hxming123456/stm32_power_measure_project/Power_measurement_self_fitting_v1.0/pyread/print.bmp

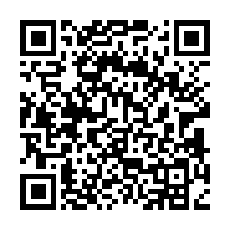
Power_measurement_self_fitting_v1.0/pyread/print.bmp
