hxming123456/stm32_power_measure_project/Power_measurement_self_fitting_v1.0/文档/1-13w功率点测量.xlsx

Sheet: Sheet1
测量点 | 白电表 | 灰电表 | 6530 | 6530带电表功率平均值 | 6530实际值 | 标准板 | 7766原始数据 | 6530空载 | 6530空载平均
1w | 1.6 | 2.03 | 2.57 | 1.6 | 0.97 | 1.68 | 55 5A 02 DD 98 00 03 63 00 3E 35 03 4B 83 4E 79 D8 2E 71 64 71 01 33 68 | 1.34 | 1.596585366
 | 1.6 | 2.03 | 2.16 | 1.6 | 0.56 | 1.78 | 55 5A 02 DD 98 00 03 61 00 3E 35 03 4E 91 4E 79 D8 2C 06 56 71 01 73 3C | 1.87
 | 1.6 | 2.05 | 3.04 | 1.6 | 1.44 | 1.66 | 55 5A 02 DD 98 00 03 62 00 3E 35 03 4C 8A 4E 79 D8 2F 45 05 71 01 95 47 | 1.05
 | 1.6 | 2.04 | 2.16 | 1.6 | 0.56 | 1.57 | 55 5A 02 DD 98 00 03 61 00 3E 35 03 44 90 4E 79 D8 31 F9 DF 71 01 AD EC | 1.87
 | 1.6 | 2.04 | 2.16 | 1.6 | 0.56 | 1.83 | 55 5A 02 DD 98 00 03 63 00 3E 35 03 56 C3 4E 79 D8 2A A7 F6 71 01 C3 07 | 1.34
3w | 3.8 | 3.87 | 3.04 | 1.6 | 1.44 | 3.51 | 55 5A 02 DD 98 00 03 5F 00 3E 35 03 41 38 4E 79 D8 16 5A F2 71 01 EB 26 | 1.34
 | 3.8 | 3.86 | 4.33 | 1.6 | 2.73 | 3.3 | 55 5A 02 DD 98 00 03 62 00 3E 35 03 4B A8 4E 79 D8 17 B6 D4 71 02 27 1F | 1.64
 | 3.8 | 3.84 | 5.33 | 1.6 | 3.73 | 3.43 | 55 5A 02 DD 98 00 03 63 00 3E 35 03 49 A8 4E 79 D8 16 D5 E8 71 02 59 82 | 1.34
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
