hxming123456/stm32_power_measure_project/Power_measurement_self_fitting_v1.0/文档/多个标准板数据对比.xlsx

Sheet: Sheet1
组数 | 6530功率 | 6530电压 | 6530电流 | 标准板功率 | 标准板电压 | 标准板电流 | 1-2000公式计算结果 | 公式计算误差 | 1-25公式计算结果 | 公式计算误差 | 功率误差百分比((标准板功率-6530功率)/6530功率) | 电压误差(标准板电压-6530电压) | 电流误差(标准板电流-6530电流)
1 | 1.5192 | 220.0702 | 0.0312 | 1.7356 | 216.8841 | 0.0729 | 1.48788396 | 2.10% | 1.44 | 5.49% | 14.24% | -3.19 | 0.04 | 0
 | 2.8572 | 220.0682 | 0.0312 | 3.3871 | 216.8591 | 0.0735 | 3.19570011 | -10.59% | 3.17 | -9.97% | 18.55% | -3.21 | 0.04 | 0
 | 3.8681 | 220.0672 | 0.0312 | 4.5252 | 217.3611 | 0.0752 | 4.37260932 | -11.54% | 4.37 | -11.45% | 16.99% | -2.71 | 0.04 | 0
 | 6.8652 | 220.0692 | 0.0412 | 6.5717 | 217.1098 | 0.0766 | 6.48889497 | 5.80% | 6.52 | 5.35% | -4.28% | -2.96 | 0.04 | 0
 | 8.6822 | 220.0772 | 0.0412 | 8.5388 | 216.8591 | 0.0816 | 8.52307308 | 1.87% | 8.58 | 1.17% | -1.65% | -3.22 | 0.04 | 0
 | 10.5852 | 220.0722 | 0.0412 | 10.3856 | 216.8591 | 0.0838 | 10.43284896 | 1.46% | 10.52 | 0.62% | -1.89% | -3.21 | 0.04 | 0
 | 11.5491 | 220.0722 | 0.0512 | 11.2356 | 216.8591 | 0.0912 | 11.31183396 | 2.10% | 11.41 | 1.20% | -2.71% | -3.21 | 0.04 | 0
 | 13.3302 | 220.0702 | 0.0512 | 13.0582 | 217.236 | 0.0921 | 13.19658462 | 1.01% | 13.33 | 0.04% | -2.04% | -2.83 | 0.04 | 0
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
