hxming123456/stm32_power_measure_project/Power_measurement_self_fitting_v1.0/文档/POWER.SCH.2.pdf

# VCC5V

5V

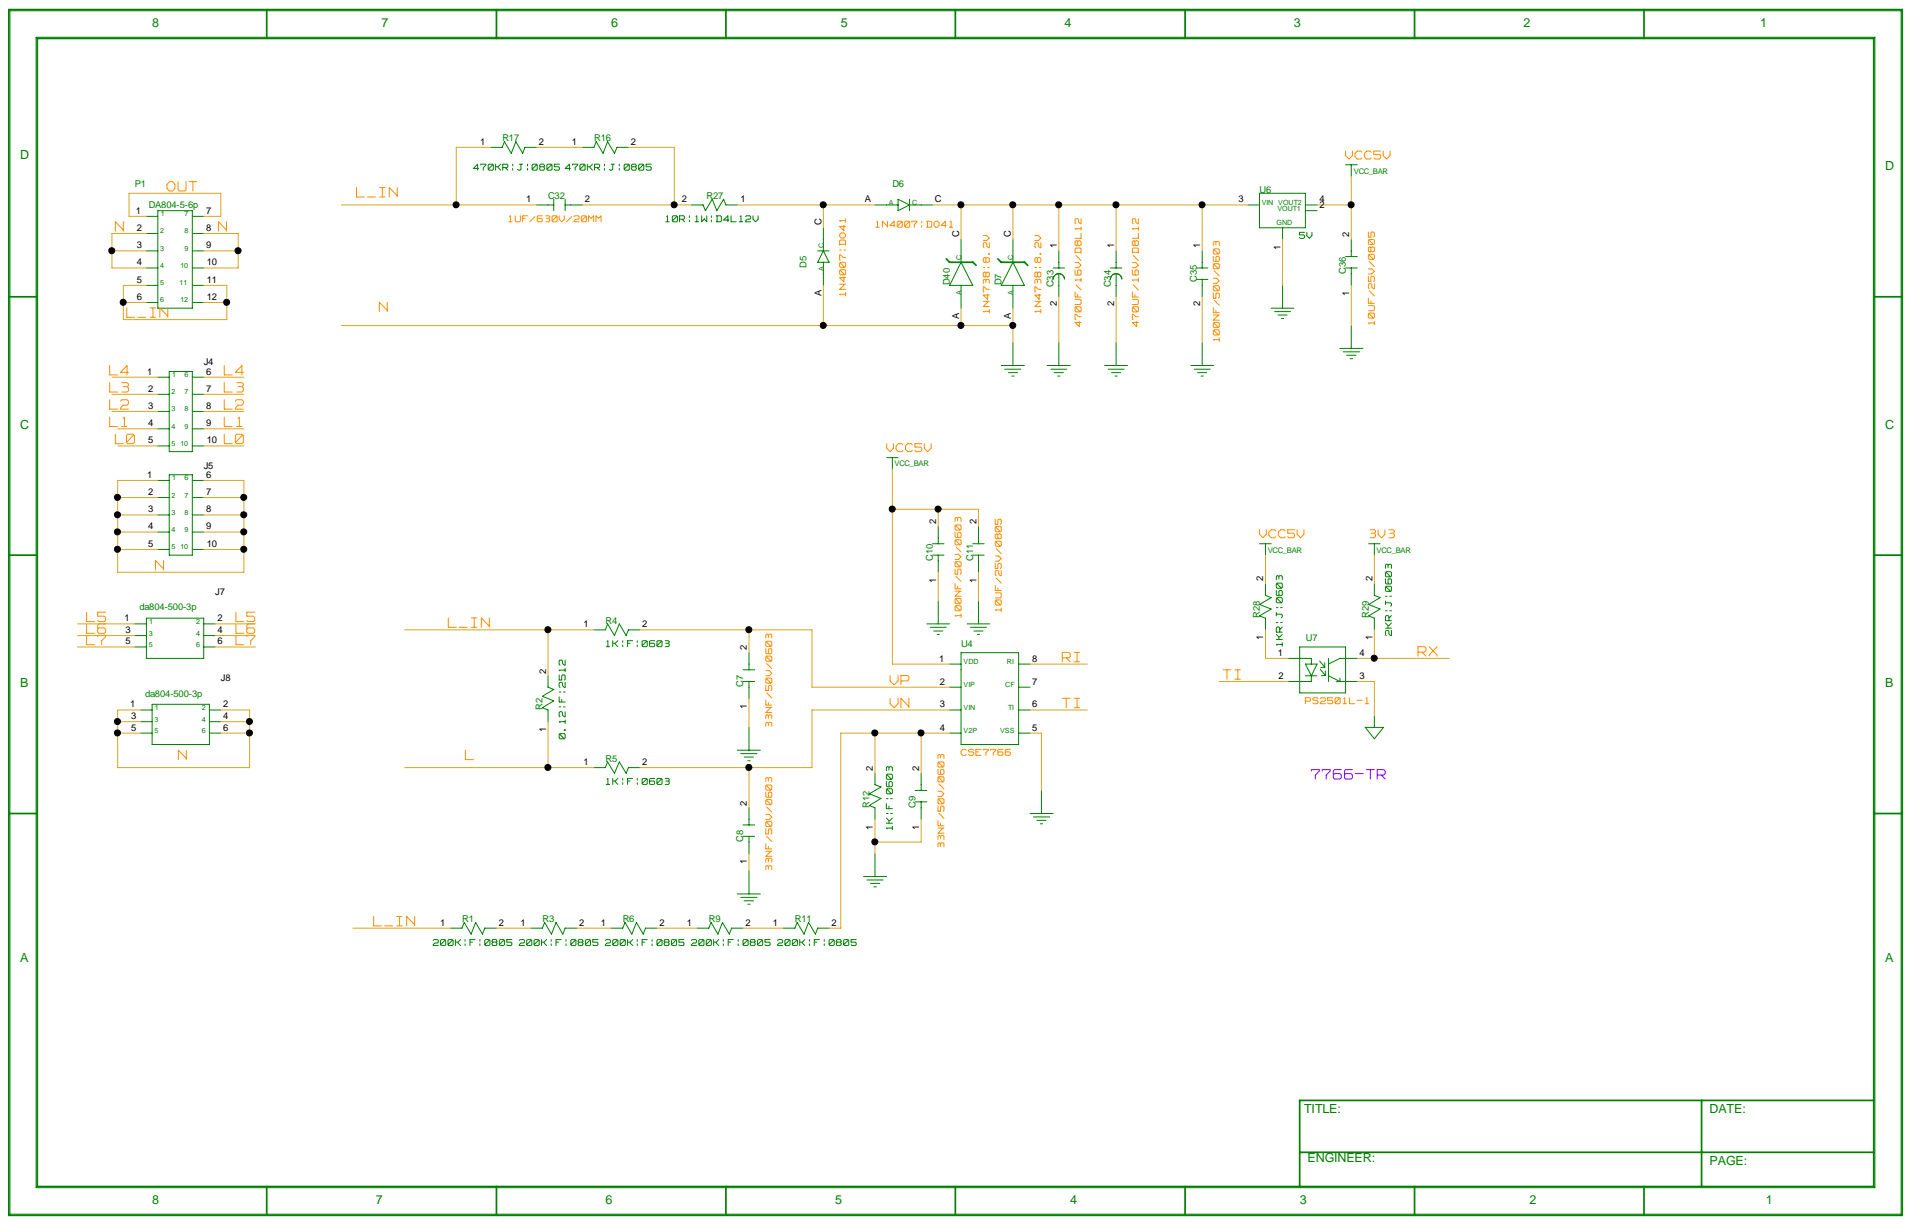
[picture p4: page 1]

# DEBUG

3V3

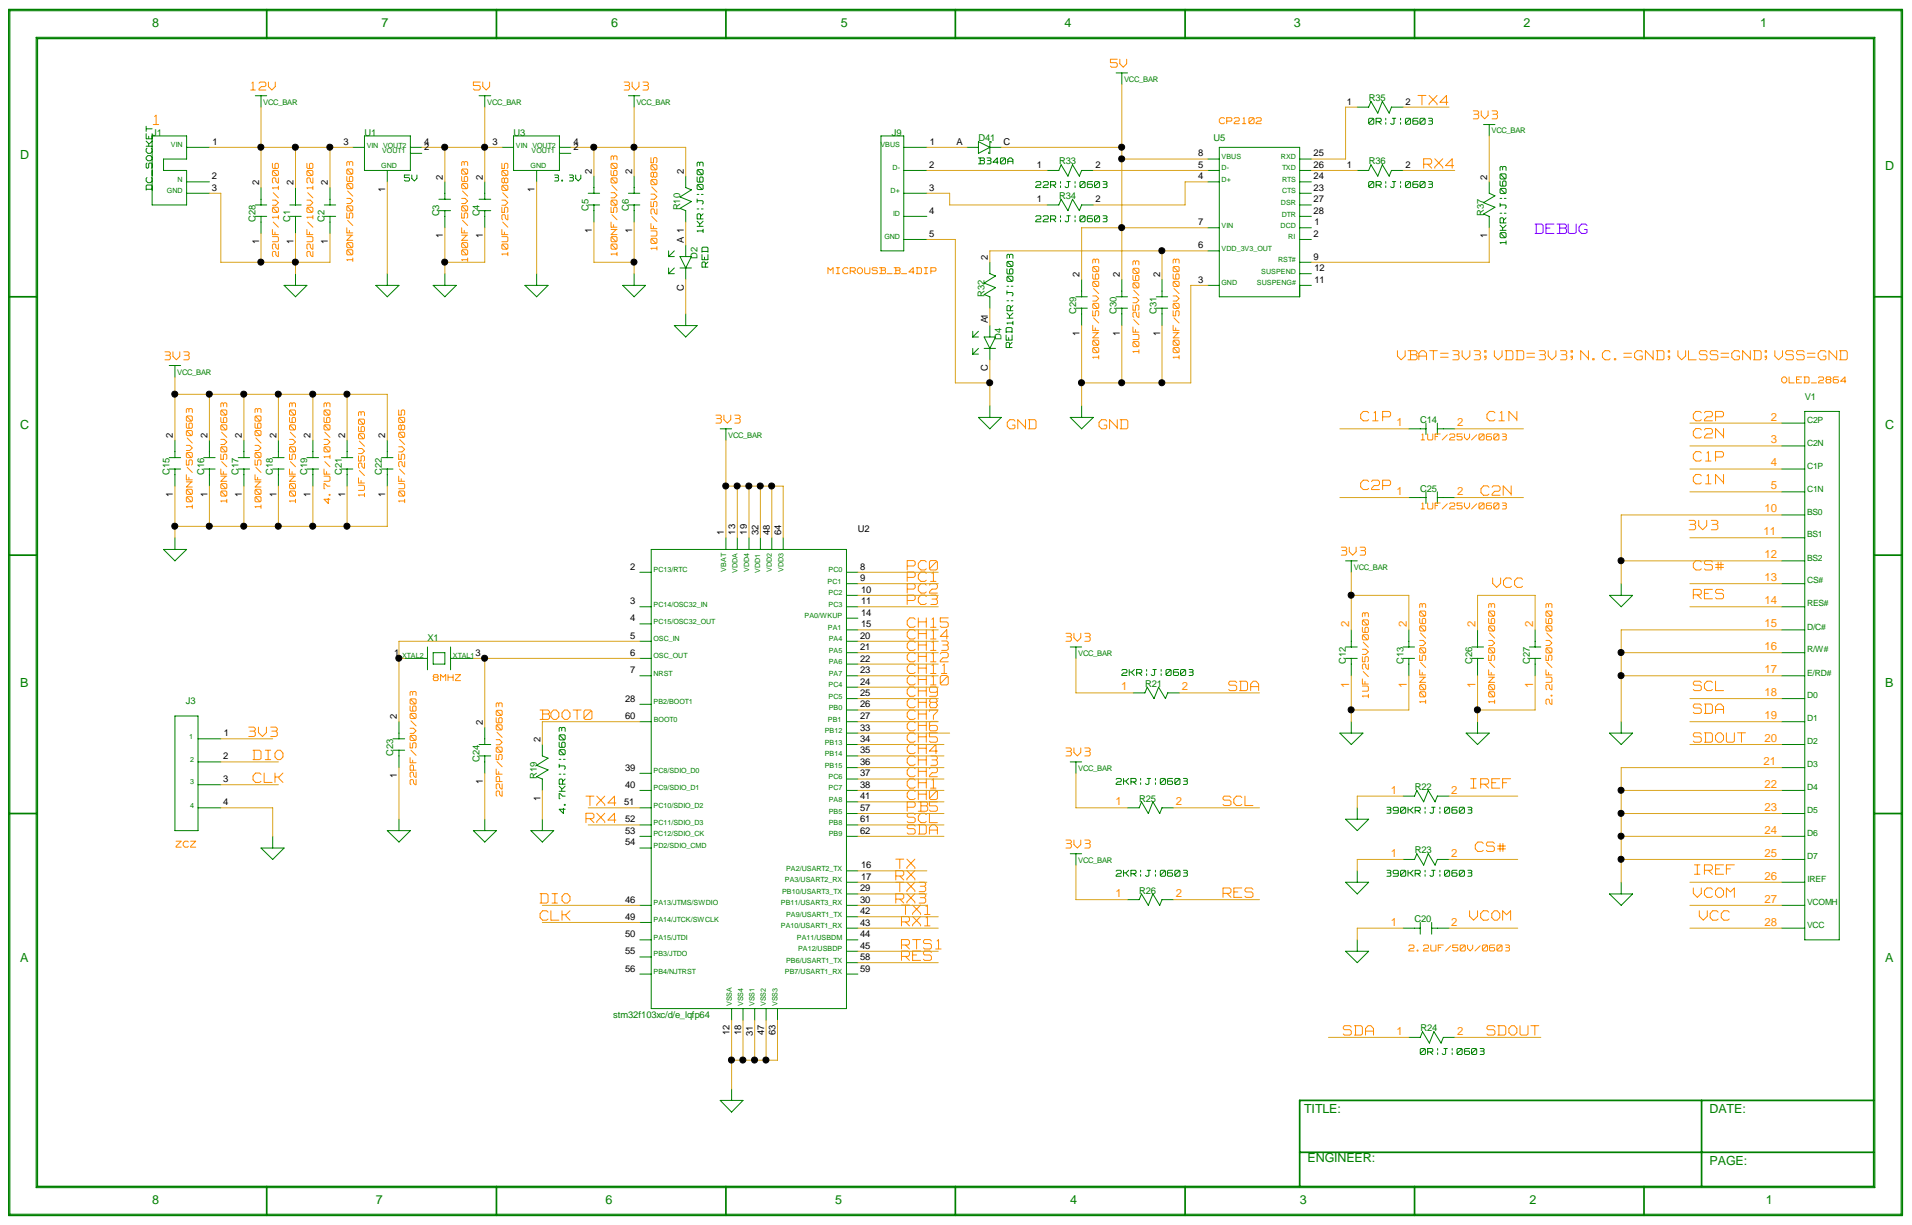
[picture p5: page 2]

VBAT=3V3;VDD=3V3;N.C.=GND;VLSS=GND;VSS=GND

TITLE: | DATE:

ENGINEER: | PAGE:

5V

3V3

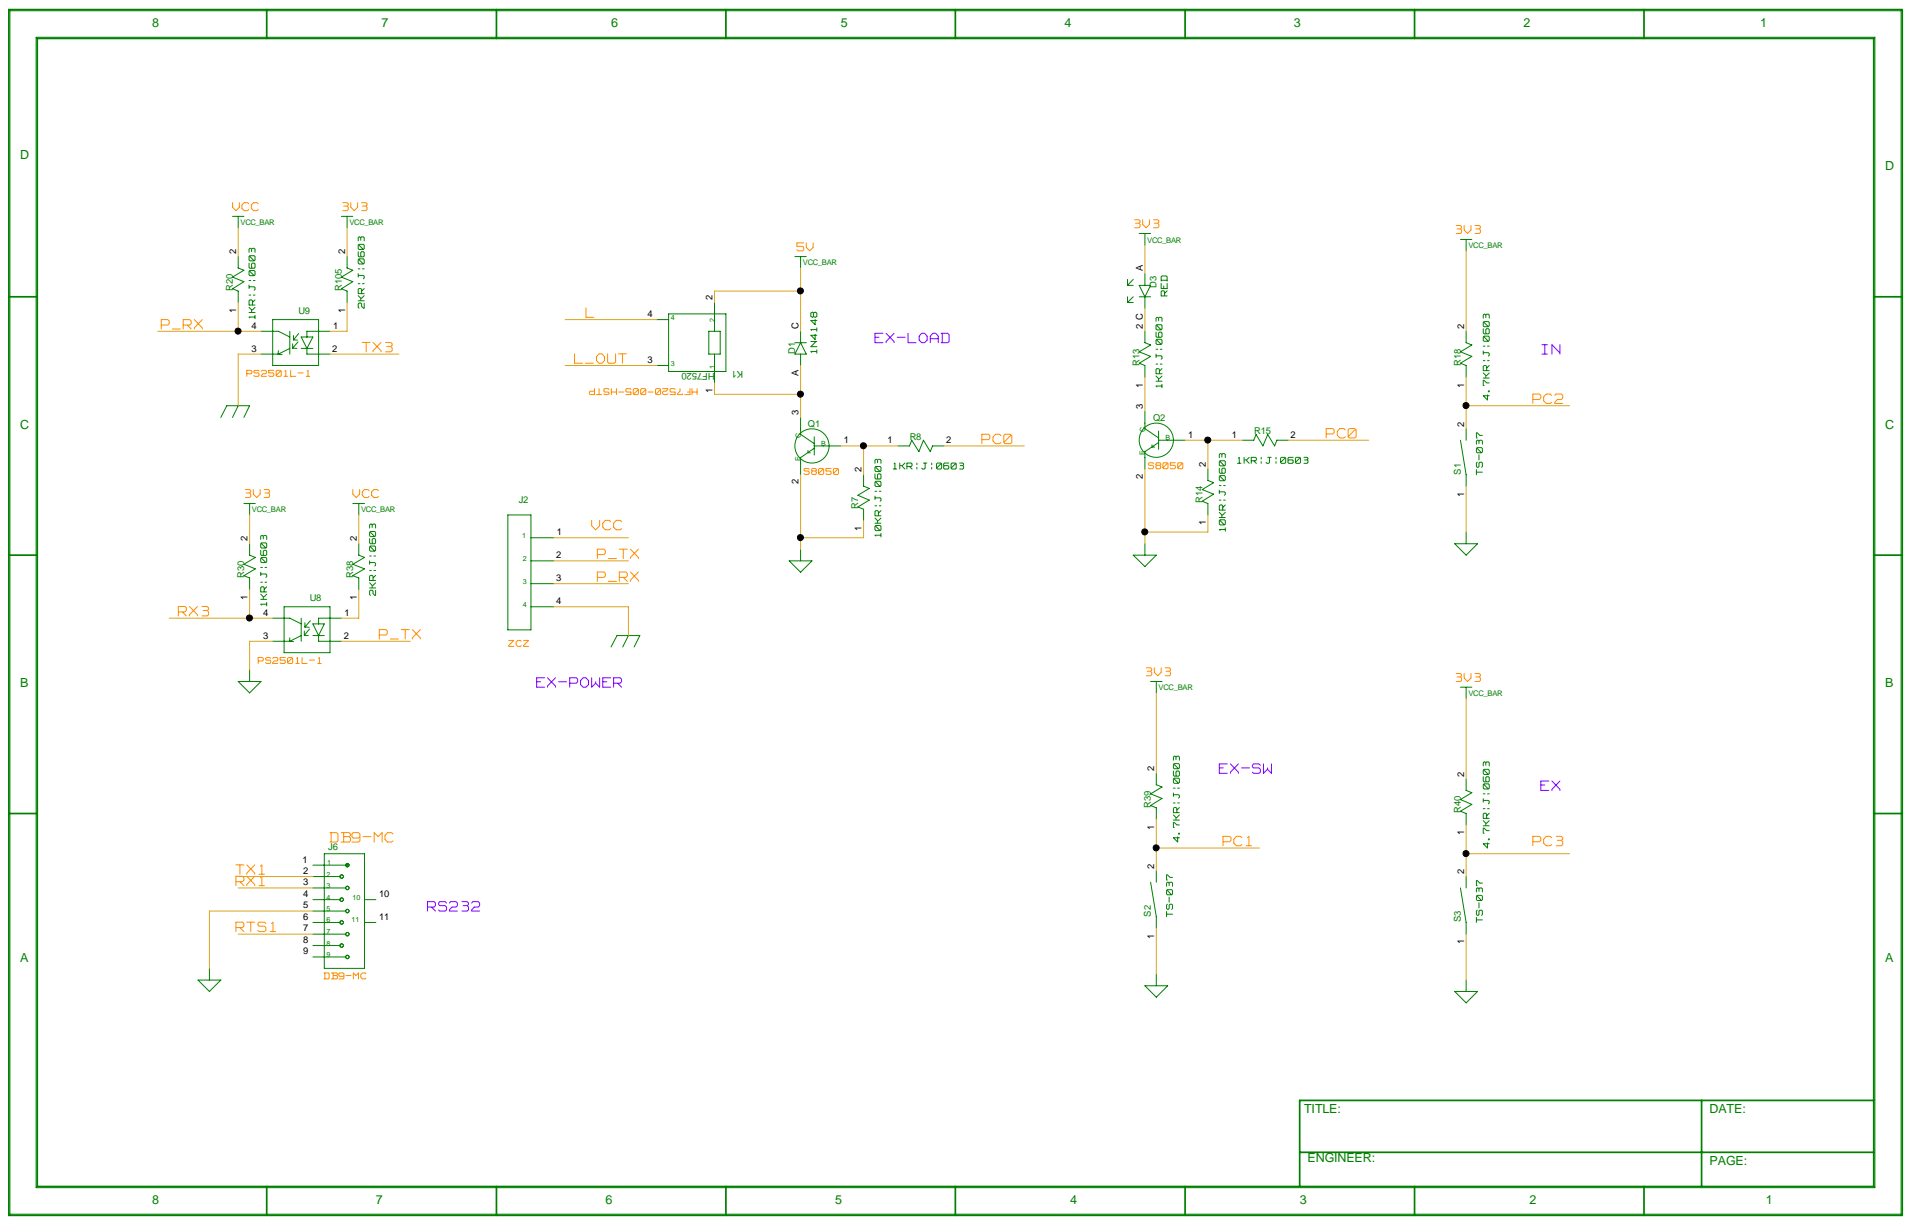
[picture p6: page 3]

TITLE: | D A TE:

E N GINEER: | PA GE:

L1

L0

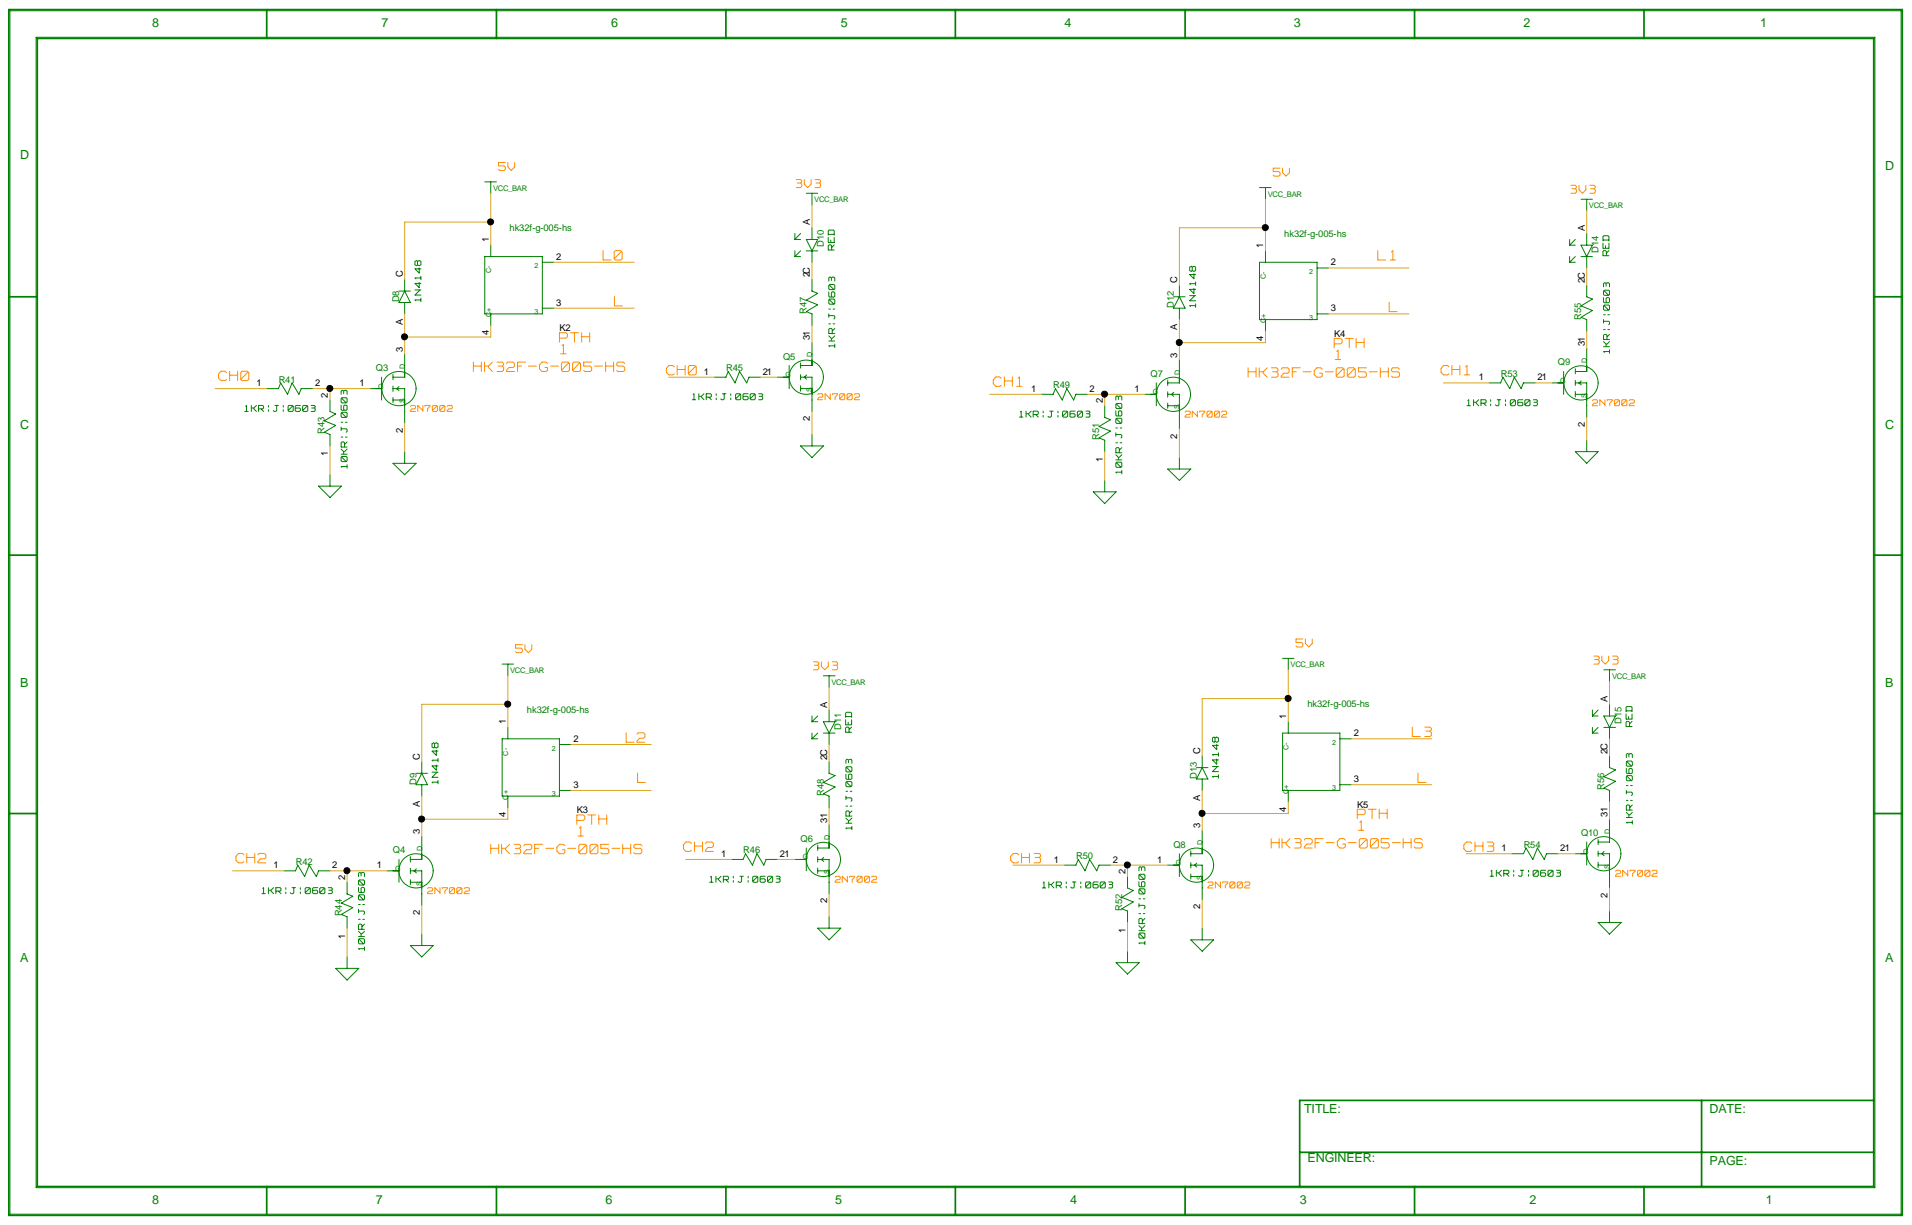
[picture p7: page 4]

TITLE: | DATE:

ENGINEER: | PAGE:

L5

L4

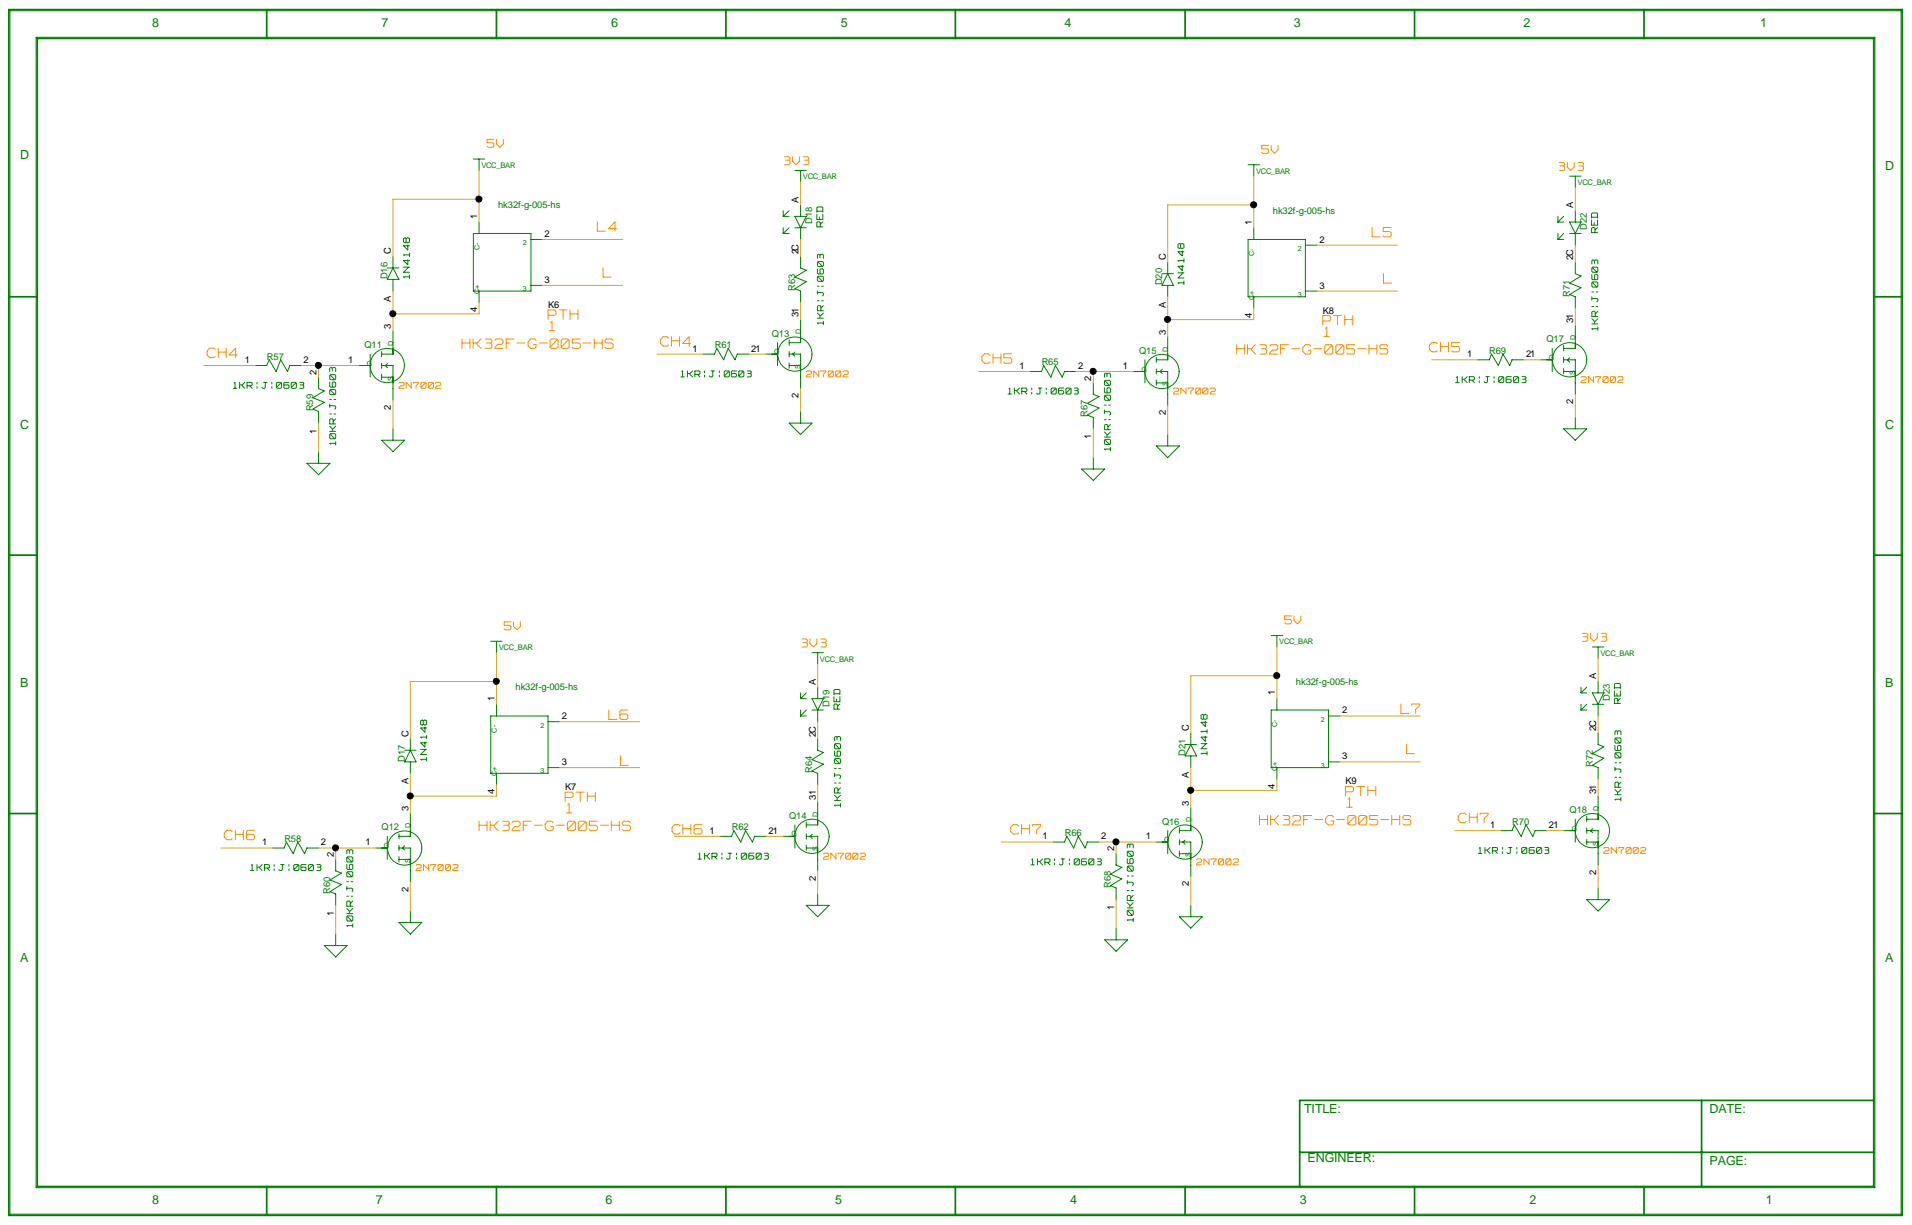
[picture p8: page 5]

TITLE: | DATE:

ENGINEER: | PAGE:

3V3

5V

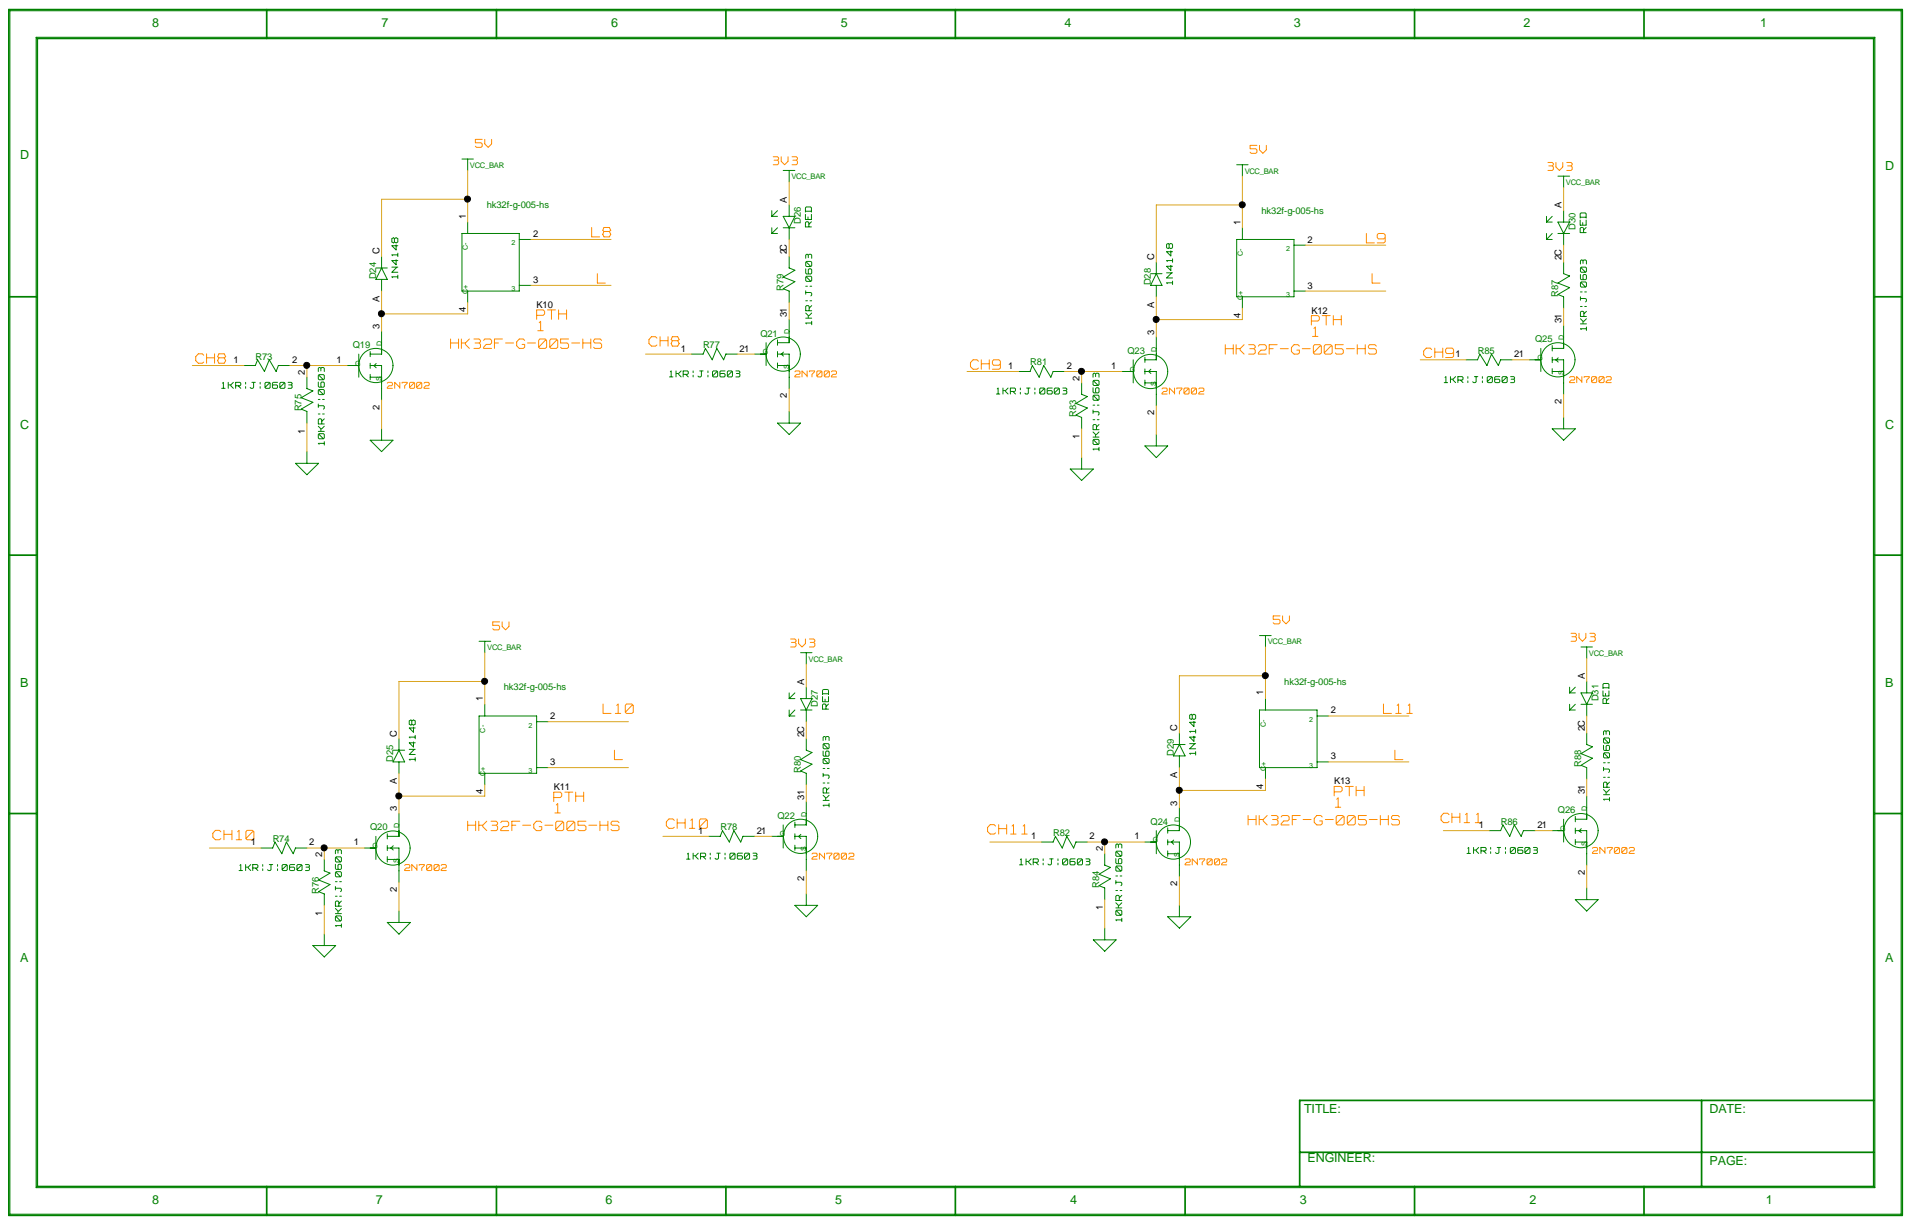
[picture p9: page 6]

TITLE: | DATE:

ENGINEER: | PAGE:

3V3

5V

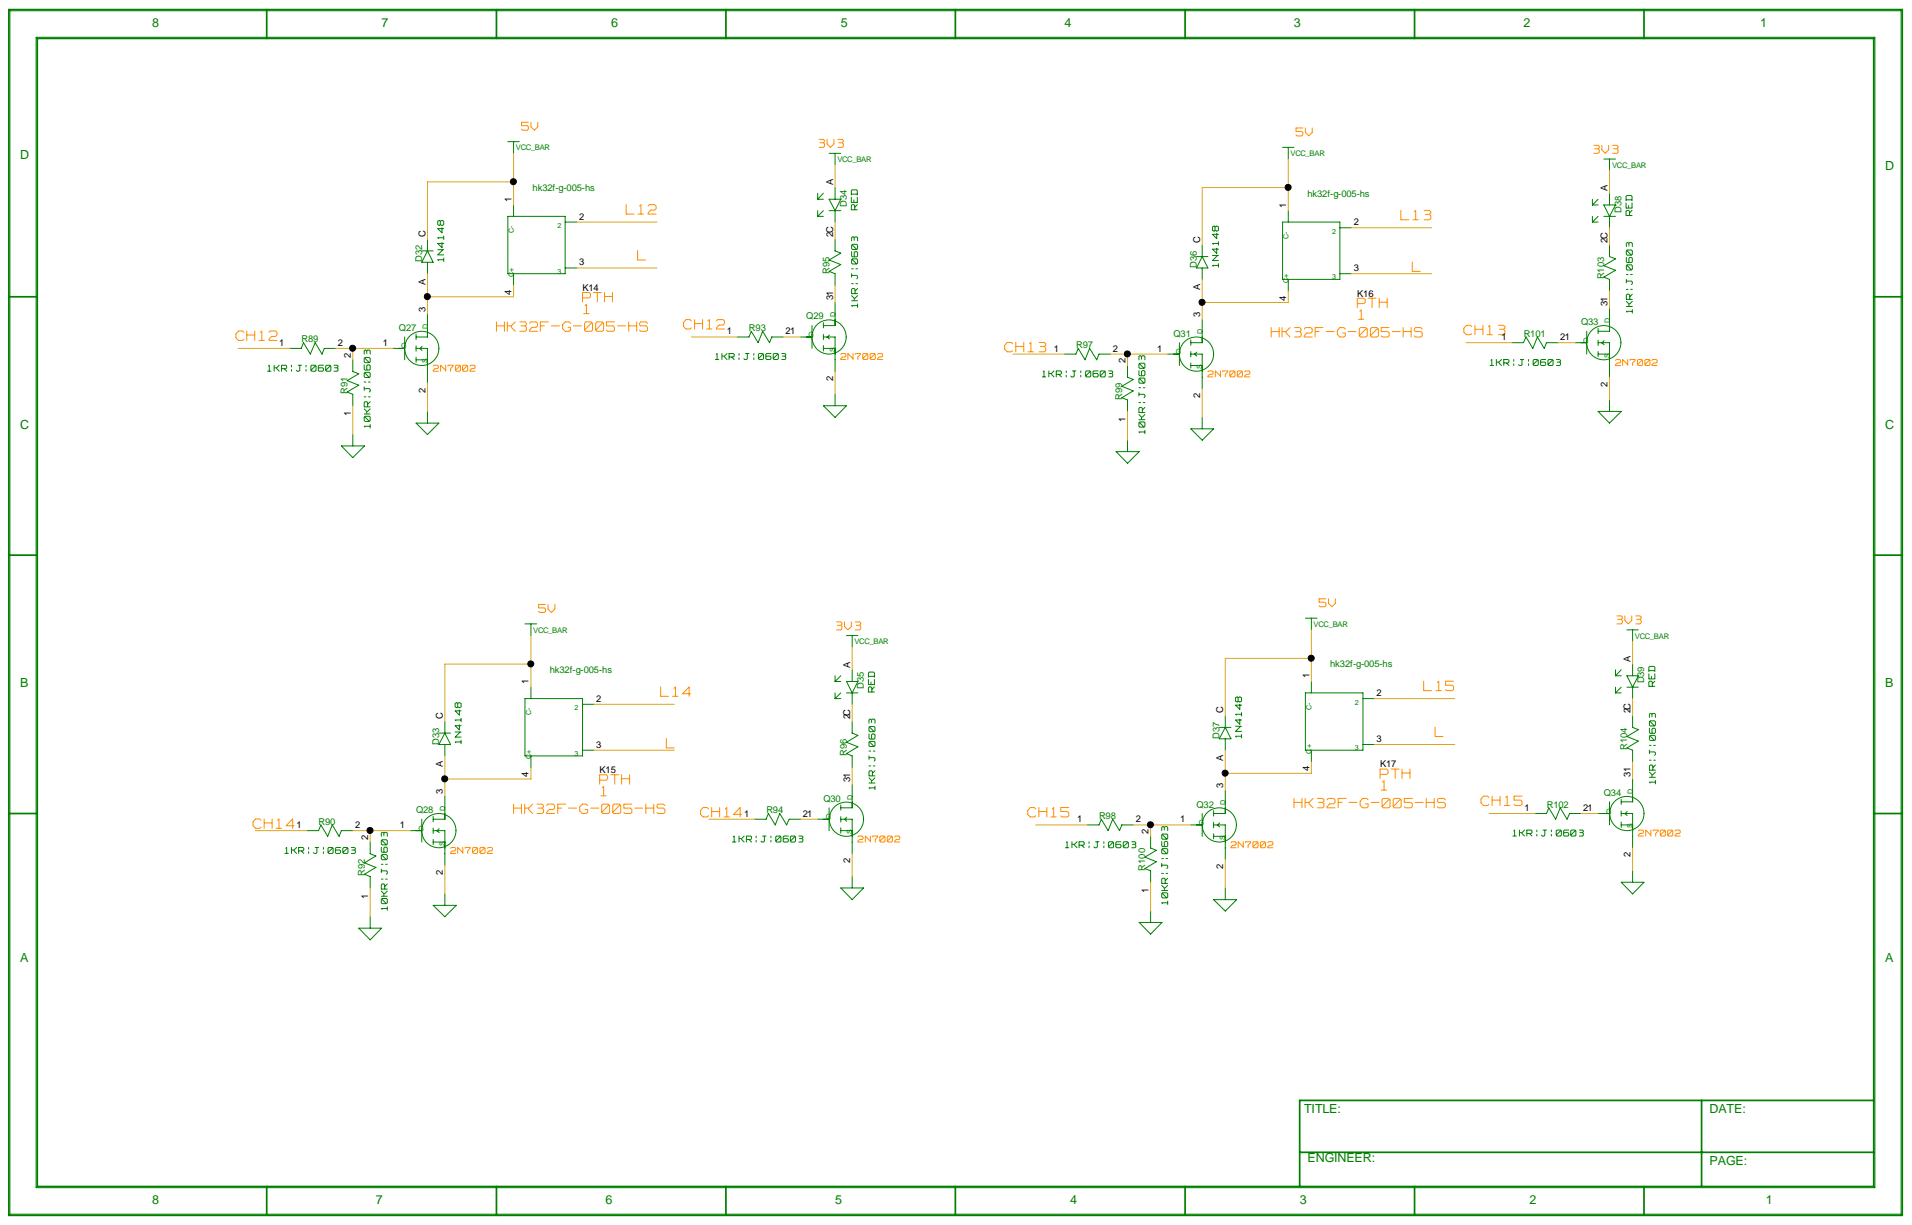
[picture p10: page 7]

TITLE: | DATE:

ENGINEER: | PAGE:
