hxming123456/stm32_power_measure_project/Power_measurement_self_fitting_v1.0/src/bsp_usart.h

#ifndef __BSP_USART_H
#define __BSP_USART_H

#include "stm32f10x.h"
#include "Data_pool.h"

#define DATA_SEND_RECV_DABUG    'N'
#define INFO_DEBUG   			'Y'
#define	TEST_DEBUG				'Y'
#define	CSE7766_DEBUG			'N'

#define CSE7766_WAIT_TIME		100
#define AC6530_WAIT_TIME		1000
#define	EXTERNAL_WAIT_TIME		100
#define OTHER_TIME				2000
#define C76_10MS_TIME			20

extern uint8_t recv_data_flag;
extern uint32_t count_time_flag;
extern uint8_t uart4_recv_flag;

void CSE7766_usart_init();
void CSE7766_usart_write(uint8_t *data,uint32_t data_len);
void CSE7766_usart_gpio_init(void);
void CSE7766_usart_change_baud(uint32_t baud);
void CSE7766_usart_nvic_init(void);

void AC6530_usart_gpio_init(void);
void AC6530_usart_nvic_init(void);
void AC6530_usart_write(uint8_t *data,uint32_t data_len);
void AC6530_usart_init();

void Debug_usart_init();
void Debug_usart_gpio_init(void);
void Debug_usart_write(void *data,uint32_t data_len,uint8_t debug_type);
int Debug_usart_read(uint8_t *data);
void Debug_usart_nvic_init(void);

void External_usart_init(void);
void External_usart_gpio_init(void);
void External_usart_nvic_init(void);
void External_usart_write(uint8_t *data,uint32_t data_len);

uint32_t pool_recv_one_command(Datapool *pool_type,uint8_t *buf,uint32_t len,uint32_t type);

#endif
