hxming123456/stm32_power_measure_project/Power_measurement_self_fitting_v1.0/src/bsp_internal_flash.h

#ifndef __BSP_INTERNAL_FLASH_H
#define __BSP_INTERNAL_FLASH_H

#include "stm32f10x.h"

void flash_read_more_data(uint32_t address,uint16_t *data,uint32_t len);
uint16_t flash_read_one_data(uint32_t address);
uint32_t flash_read32_data(uint32_t address);
uint32_t flash_write_more_data(uint32_t address,uint16_t *data,uint32_t len);

#endif
