hxming123456/stm32_power_measure_project/(commit log)

2017-07-21 add project
    [shju.xls]
2017-07-25 add new branch
    [shju.xls]
2017-07-28 Optimization algorithm
    [shju.xls, 数据.xlsx]
2017-07-28 change uart config
2017-08-14 voltage compensation
2017-08-23 add 110v and 220v support
2017-09-01 update version2017_9_1,220,110 self_adjust_ok,external_no_try
    [标准板_1数据.xlsx]
2017-09-04 version2017_9_4,delete some file
    [1-13w功率点测量.xlsx, 多个标准板数据对比.xlsx, 数据.xlsx, 标准板_1数据.xlsx]
